gleijten/LedstripController/DesignSpark/Readme.md

The files are made with DesignSpark PCB Explorer 11.0.

Download all files in a directory and open the projectfile with DesignSpark PCB Explorer 11.0

You can download the DesignSpark PCB Explorer program via https://www.rs-online.com/designspark/pcb-download-and-installation
