gleijten/LedstripController/Arduino/Readme.md

To create your own "my_secret.h" see:
<BR>

https://docs.arduino.cc/arduino-cloud/cloud-editor/store-your-sensitive-data-safely-when-sharing/
