gleijten/LedstripController/extras/PCB.png

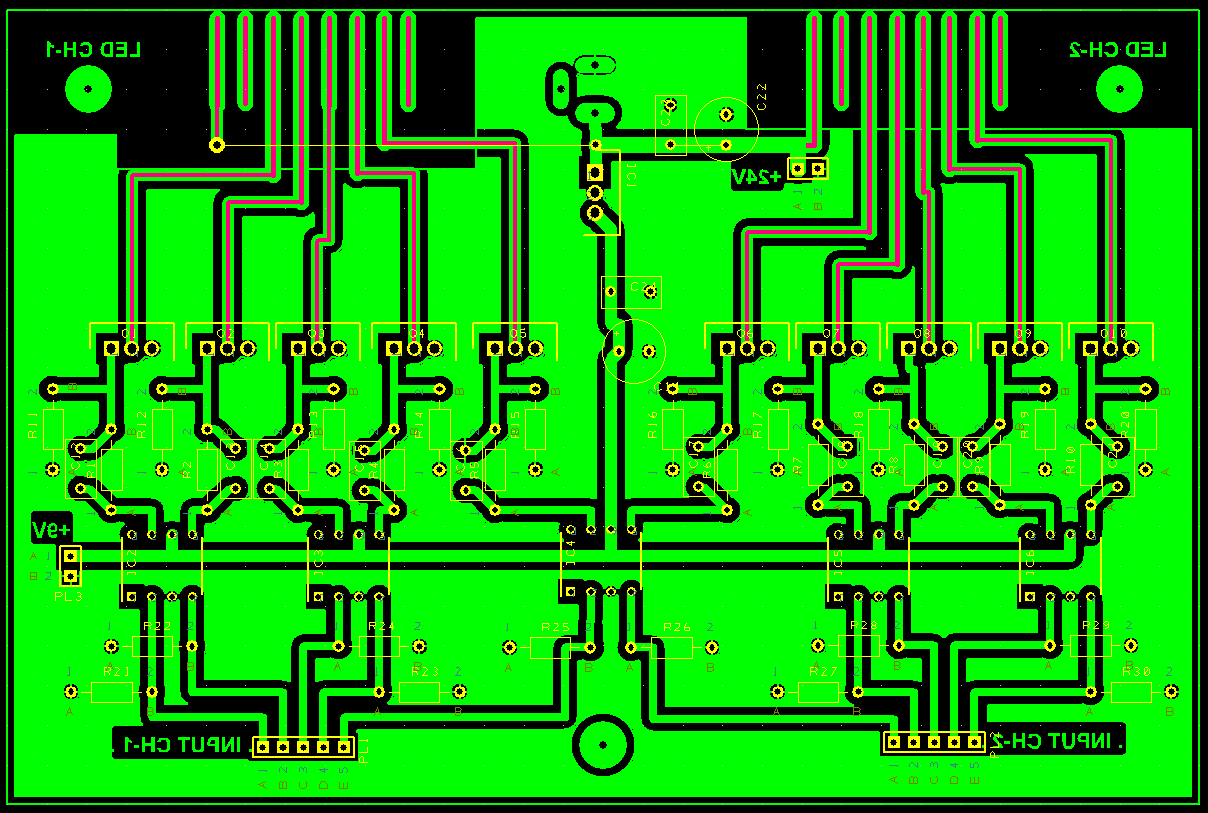
extras/PCB.png
