gleijten/LedstripController/extras/Schema_cpl.png

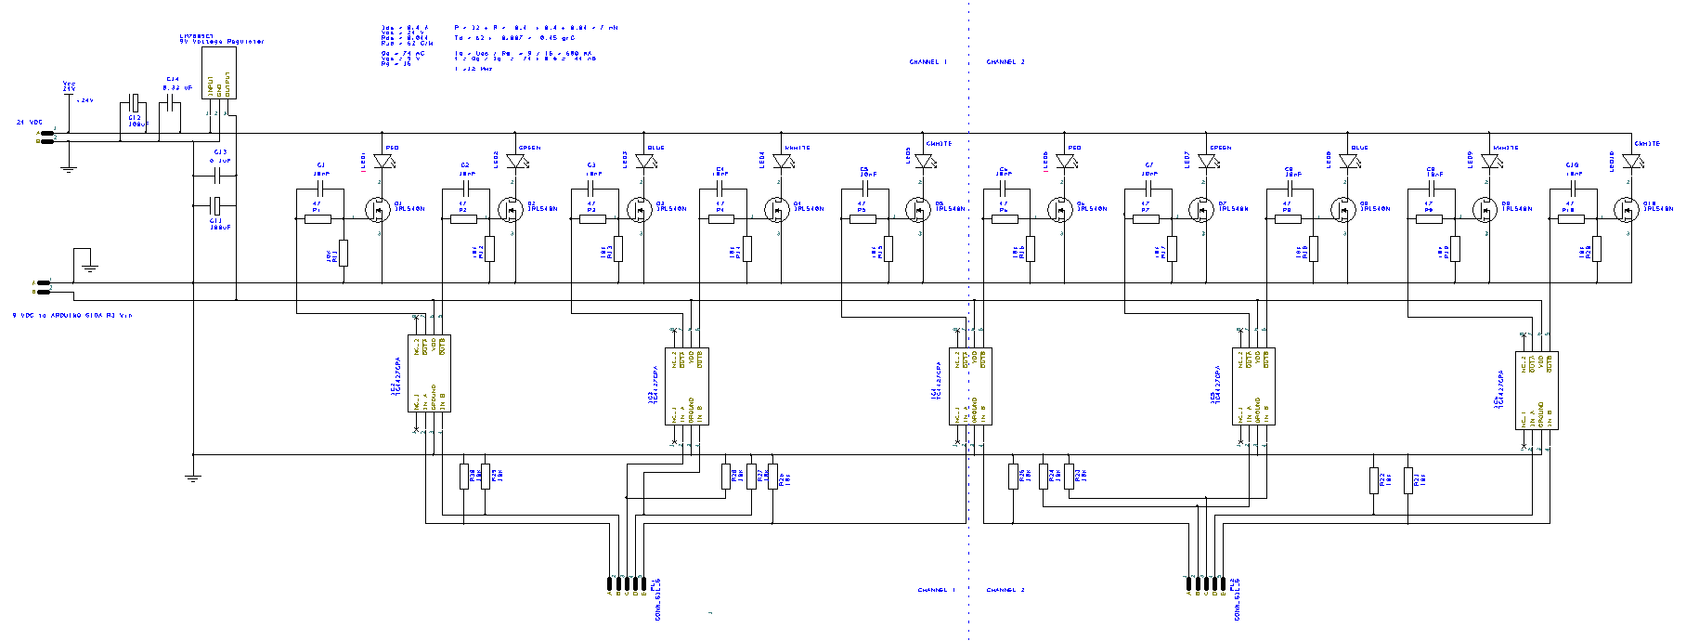
extras/Schema_cpl.png
