gleijten/LedstripController/(list of files, drawings)

Other design files:
DesignSpark/Ledstripsturing.pcb
